faisal2470/RocketDesign/MultiStage/Figures/Multi_Stage_Full.png

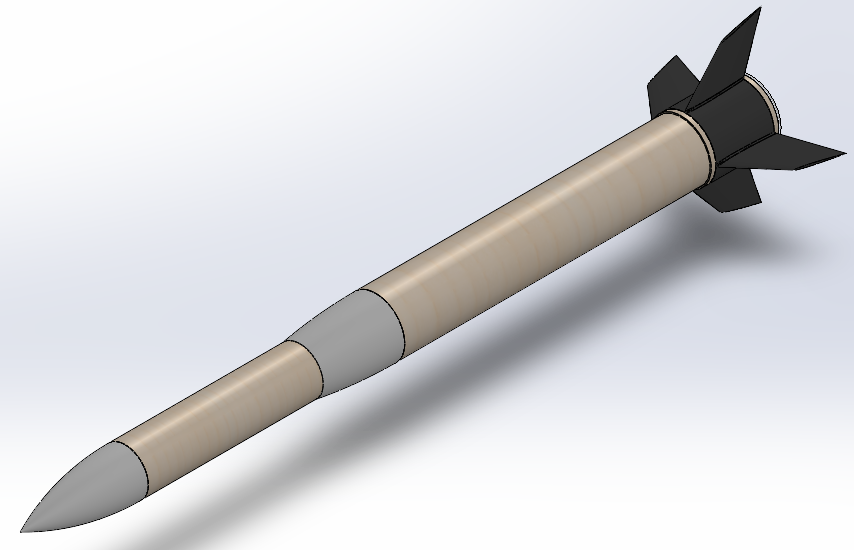
MultiStage/Figures/Multi_Stage_Full.png
