faisal2470/RocketDesign/MultiStage/Figures/Upper_Body_Tube_Multi.png

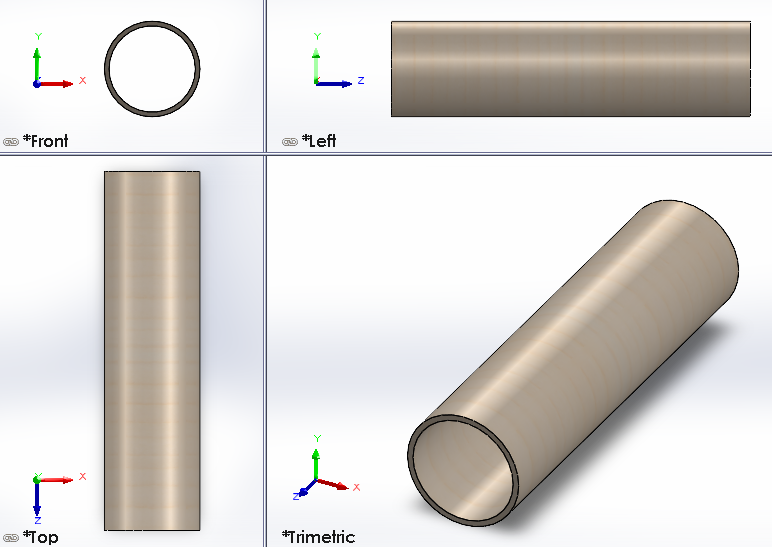
MultiStage/Figures/Upper_Body_Tube_Multi.png
