faisal2470/RocketDesign/Appendix/SemiOgive.pdf

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

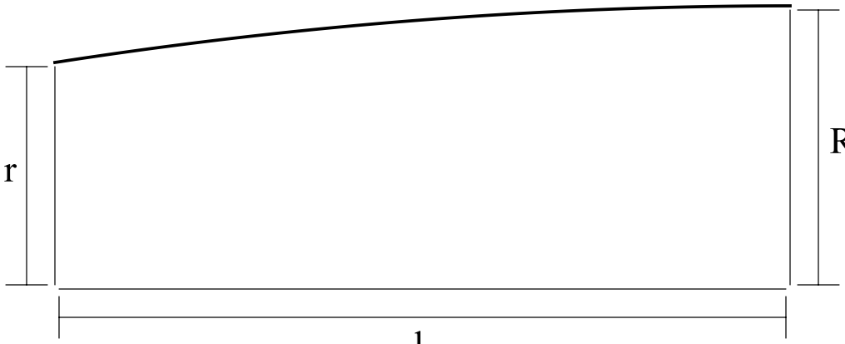
[picture p30: figure]
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
