faisal2470/RocketDesign/MultiStage/Figures/Acc_Vel_Multi.png

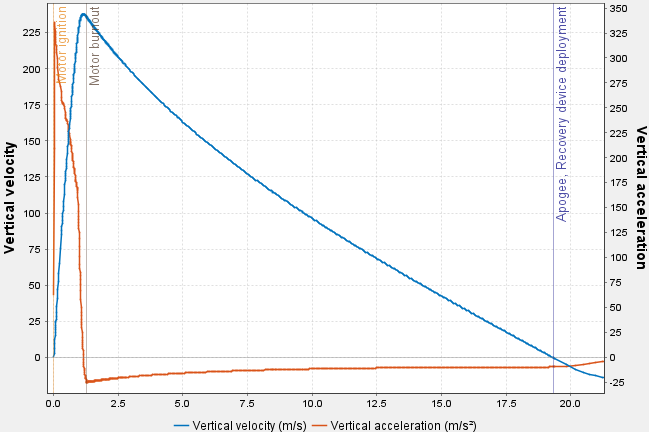
MultiStage/Figures/Acc_Vel_Multi.png
