faisal2470/RocketDesign/MultiStage/Figures/Exploded_View_Multi.png

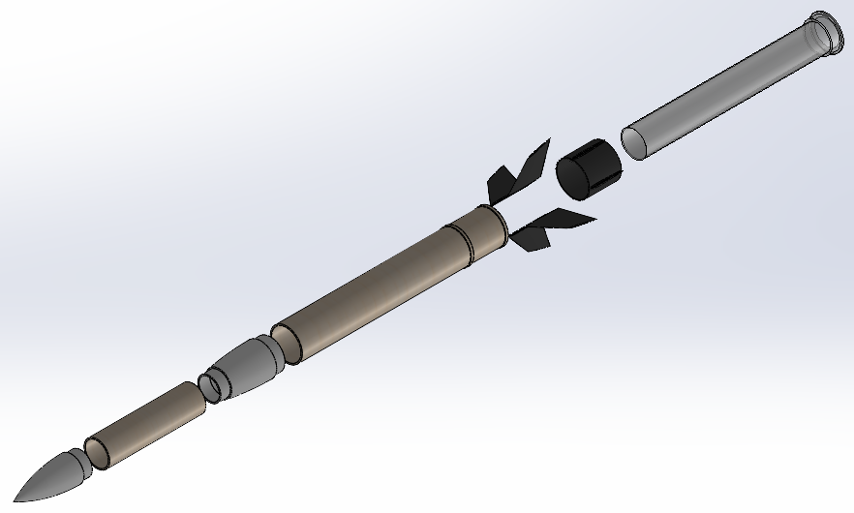
MultiStage/Figures/Exploded_View_Multi.png
