faisal2470/RocketDesign/MultiStage/Figures/Fin_Multi.png

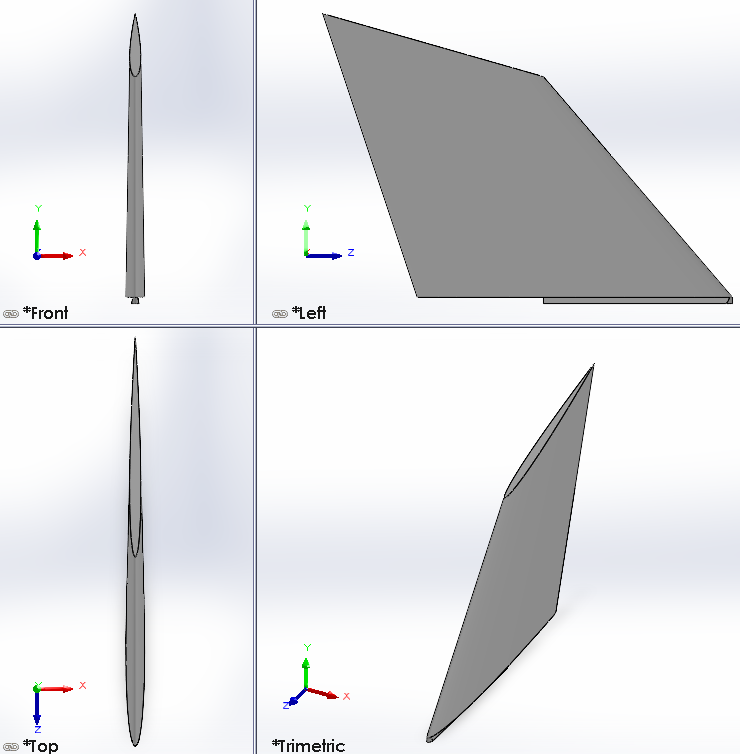
MultiStage/Figures/Fin_Multi.png
