faisal2470/RocketDesign/MultiStage/Figures/Fin_Ring_Multi.png

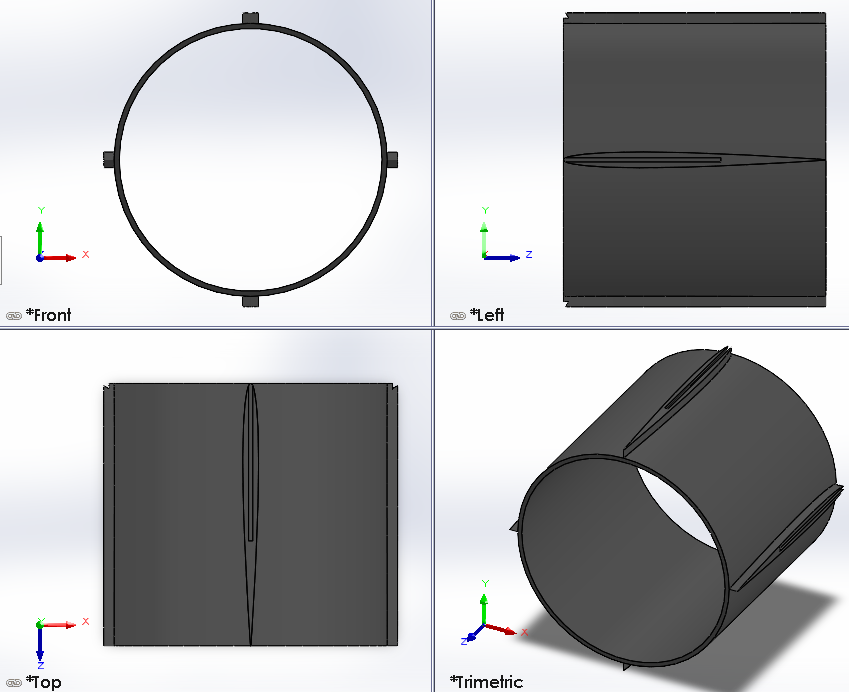
MultiStage/Figures/Fin_Ring_Multi.png
