faisal2470/RocketDesign/MultiStage/Figures/Flight_Path_Multi.png

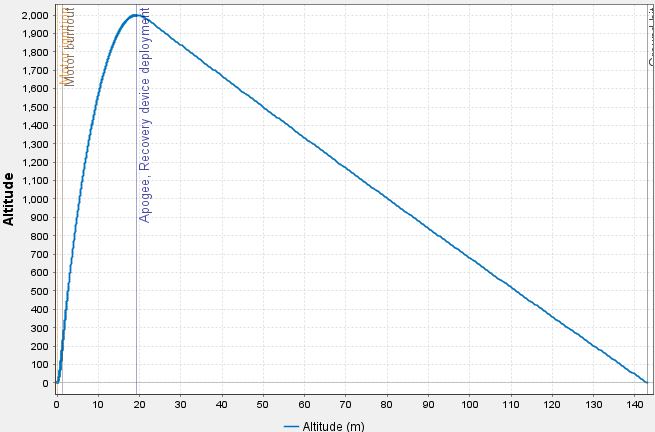
MultiStage/Figures/Flight_Path_Multi.png
