faisal2470/RocketDesign/MultiStage/Figures/Lower_Body_Tube_Multi.png

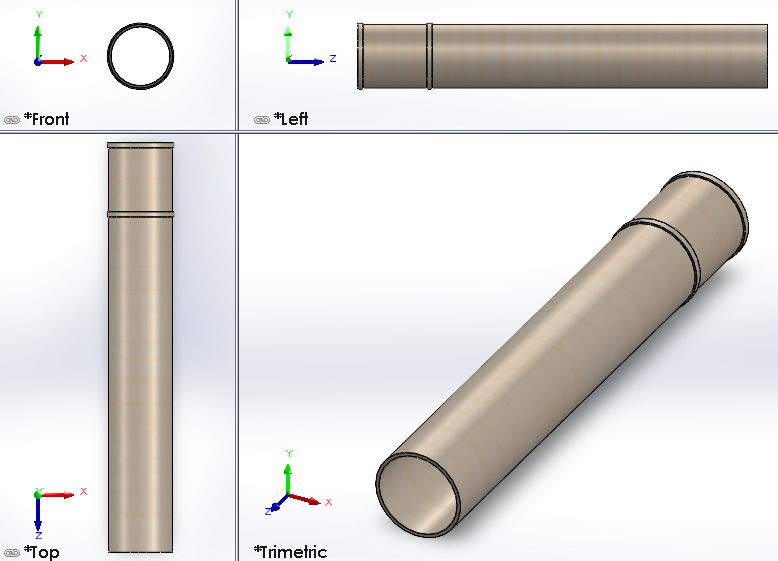
MultiStage/Figures/Lower_Body_Tube_Multi.png
