faisal2470/RocketDesign/MultiStage/Figures/Motor_Mount_Multi.png

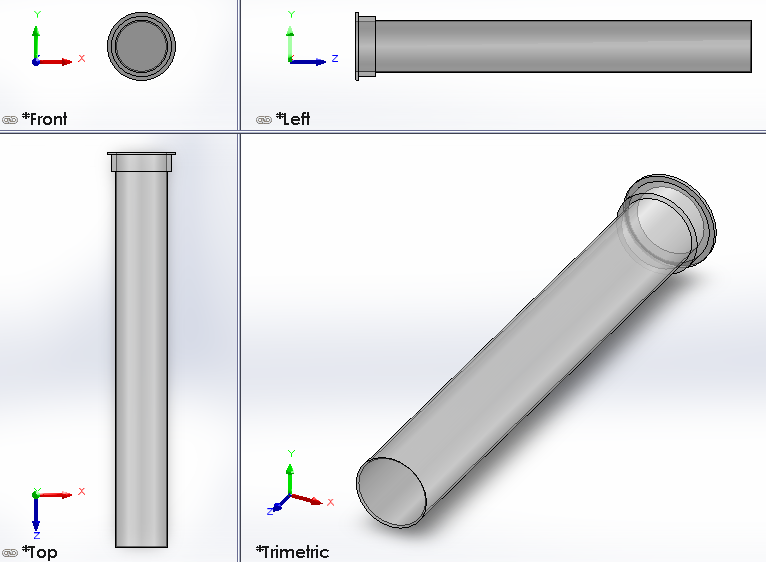
MultiStage/Figures/Motor_Mount_Multi.png
