faisal2470/RocketDesign/MultiStage/Figures/Nose_Cone_Multi.png

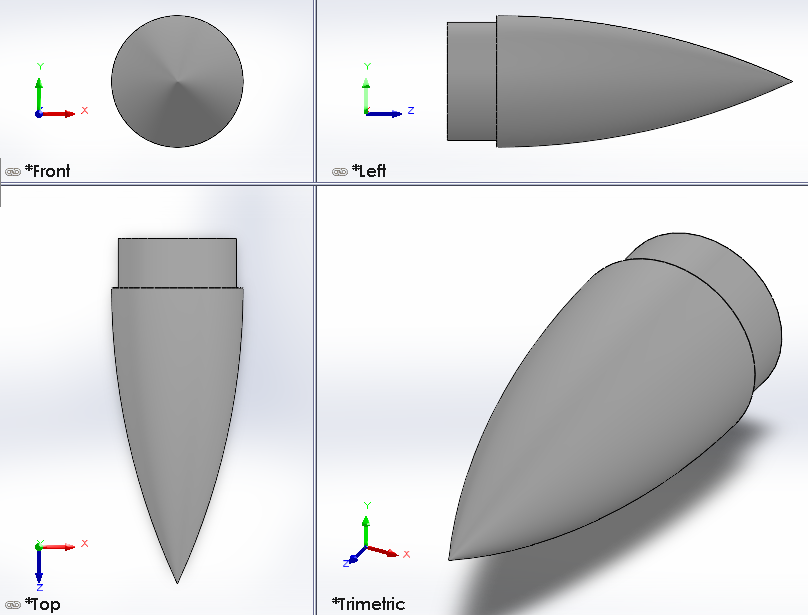
MultiStage/Figures/Nose_Cone_Multi.png
