faisal2470/RocketDesign/MultiStage/Figures/Transition_Multi.png

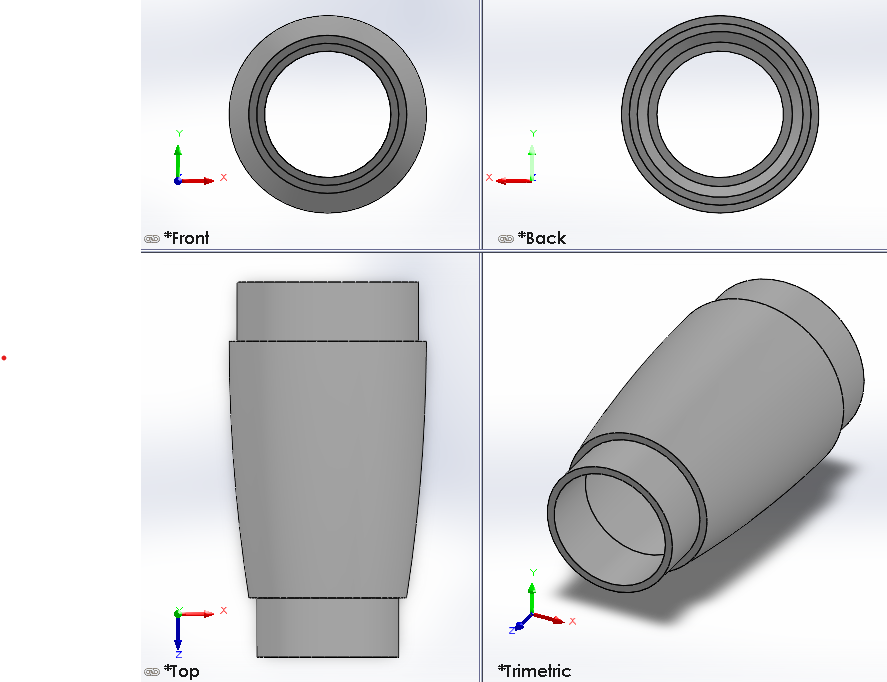
MultiStage/Figures/Transition_Multi.png
