faisal2470/RocketDesign/SingleStage/Figures/Acc_Vel_Single.png

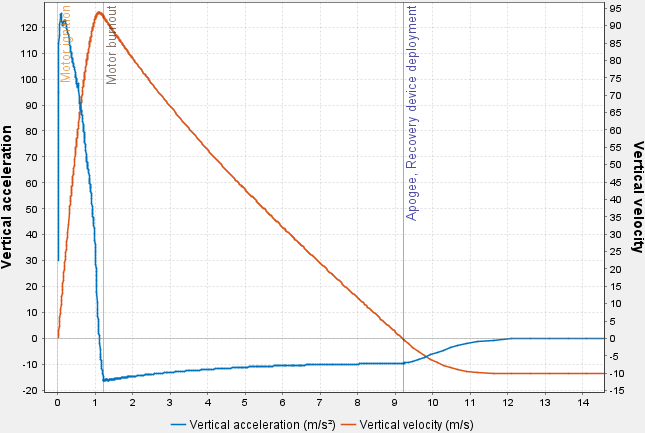
SingleStage/Figures/Acc_Vel_Single.png
