faisal2470/RocketDesign/SingleStage/Figures/Body_Tube.png

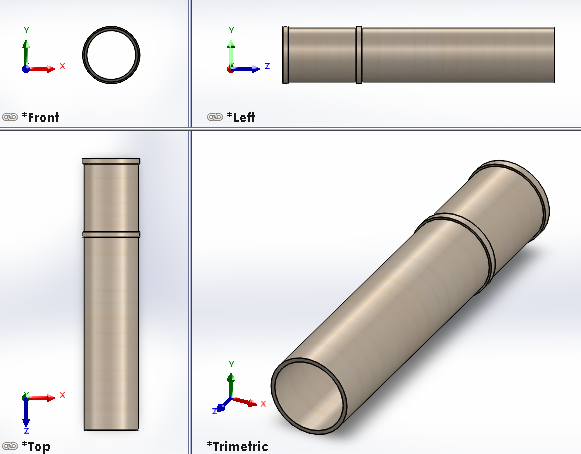
SingleStage/Figures/Body_Tube.png
