faisal2470/RocketDesign/SingleStage/Figures/Exploded_View.png

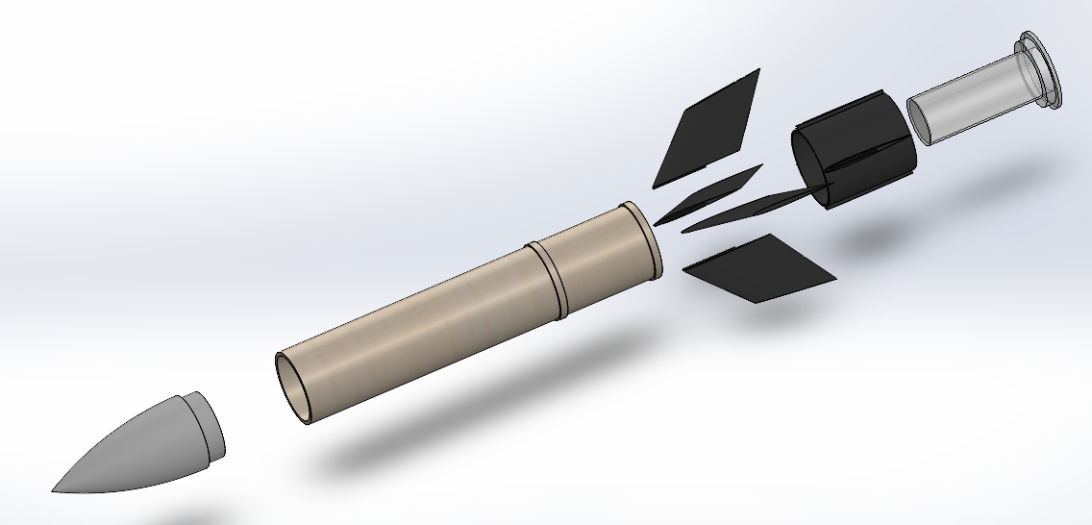
SingleStage/Figures/Exploded_View.png
