faisal2470/RocketDesign/SingleStage/Figures/Fin_Ring.png

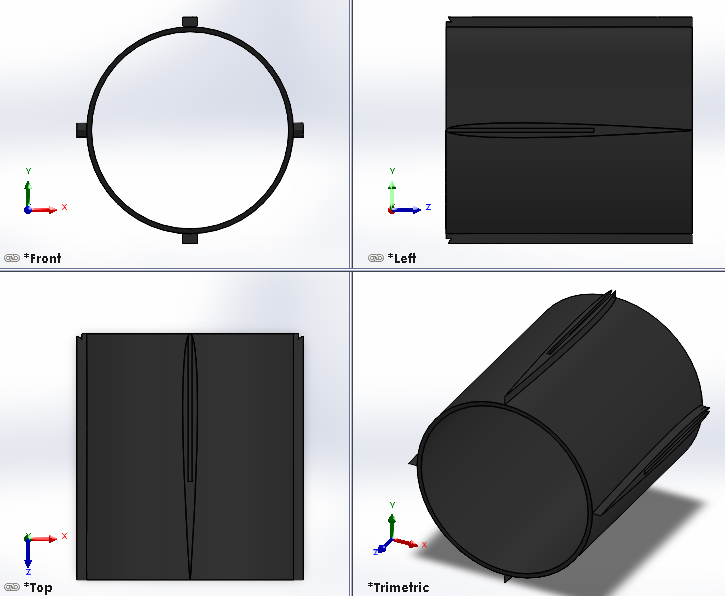
SingleStage/Figures/Fin_Ring.png
