faisal2470/RocketDesign/SingleStage/Figures/Fins_sld.png

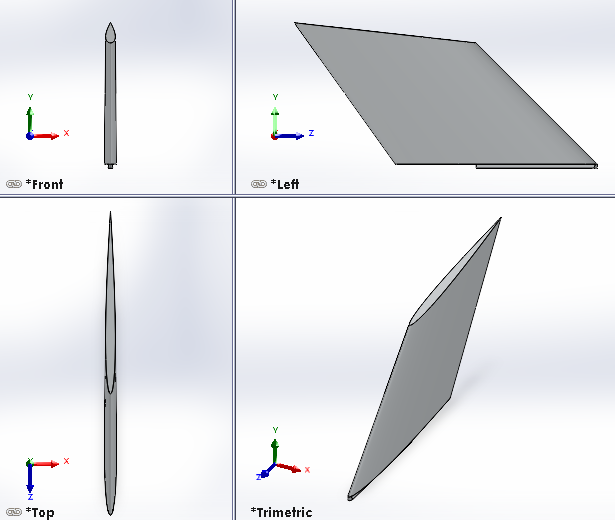
SingleStage/Figures/Fins_sld.png
