faisal2470/RocketDesign/SingleStage/Figures/Flight_Path_Single.png

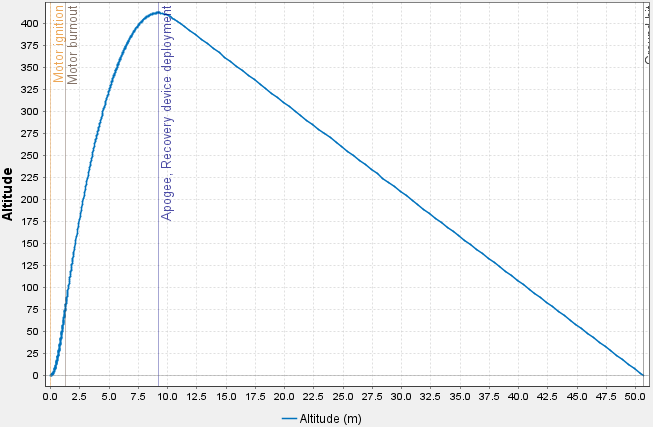
SingleStage/Figures/Flight_Path_Single.png
