faisal2470/RocketDesign/SingleStage/Figures/Motor_Mount.png

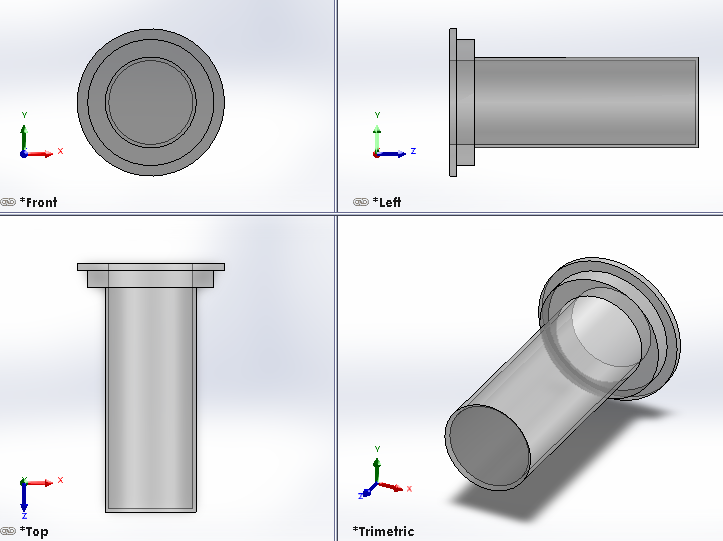
SingleStage/Figures/Motor_Mount.png
