faisal2470/RocketDesign/SingleStage/Figures/Nose_Cone.png

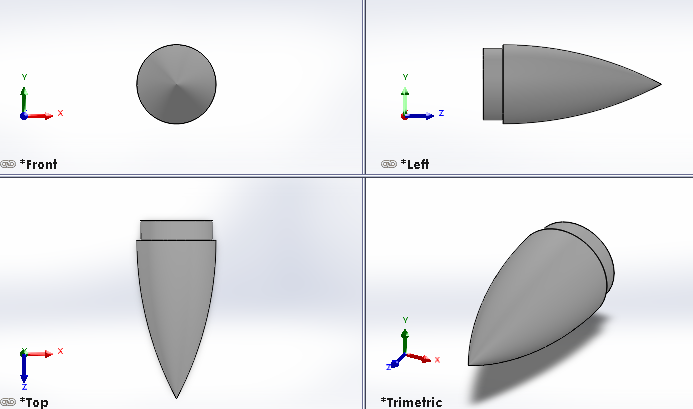
SingleStage/Figures/Nose_Cone.png
