faisal2470/RocketDesign/SingleStage/Figures/Single.png

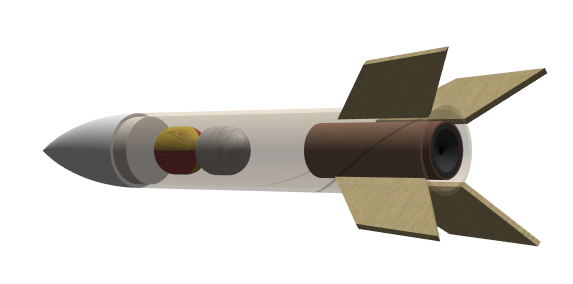
SingleStage/Figures/Single.png
