faisal2470/RocketDesign/MultiStage/SolidPart/Multi Stage Rocket.SLDASM

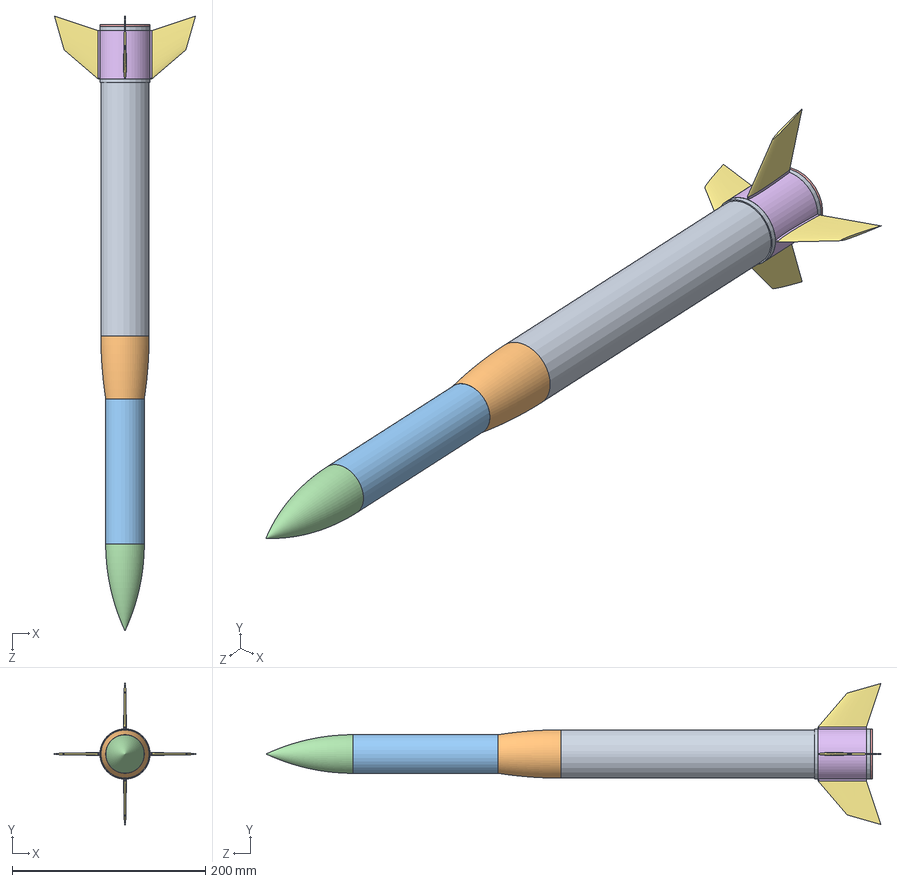
[picture p49: CAD file, 2024-01-03]
MultiStage/SolidPart/Multi Stage Rocket.SLDASM
146.0 x 146.0 x 636.0 mm
Lower Body Tube
Transition
Upper Body Tube
Nose Cone
Motor Mount
Fin Ring
Fins x 4
