faisal2470/RocketDesign/SingleStage/SolidPart/Single_Stage.SLDASM

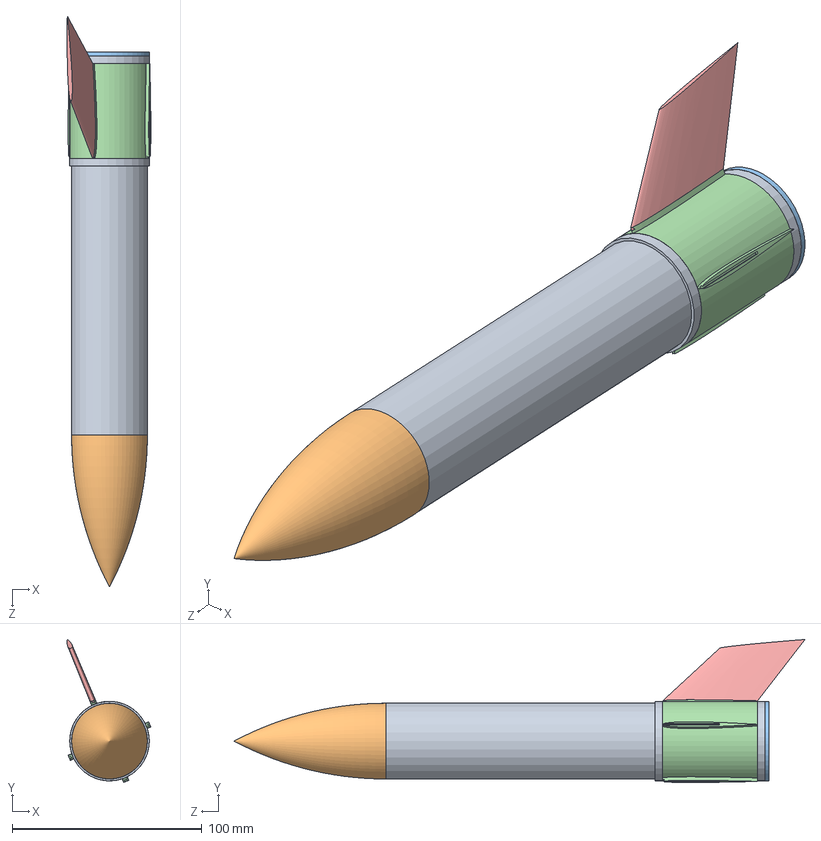
[picture p50: CAD file, 2024-01-03]
SingleStage/SolidPart/Single_Stage.SLDASM
44.2 x 75.4 x 301.0 mm
Body_Tube
Nose_Cone
Motor_Mount
Fin_Ring
Fins
