faisal2470/RocketDesign/MultiStage/SolidPart/Fin Ring.SLDPRT

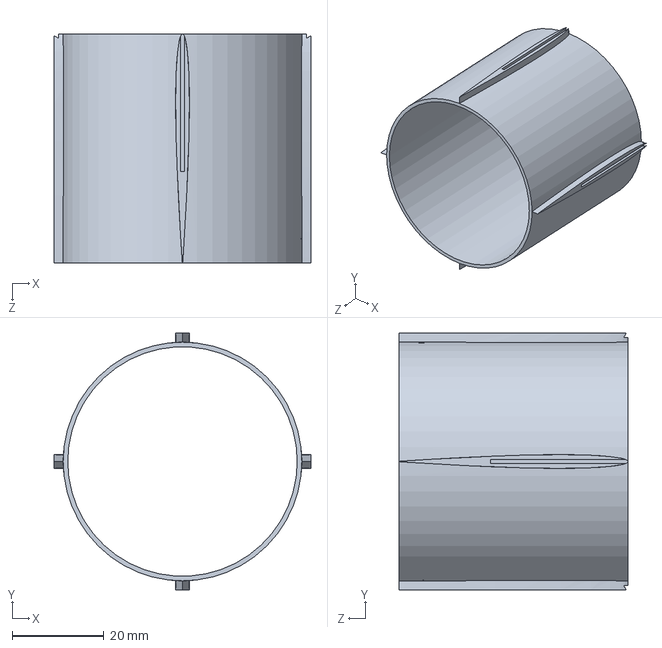
[picture p51: CAD file, 2024-01-03]
MultiStage/SolidPart/Fin Ring.SLDPRT
56.0 x 56.0 x 50.0 mm
