faisal2470/RocketDesign/SingleStage/SolidPart/Fin_Ring.SLDPRT

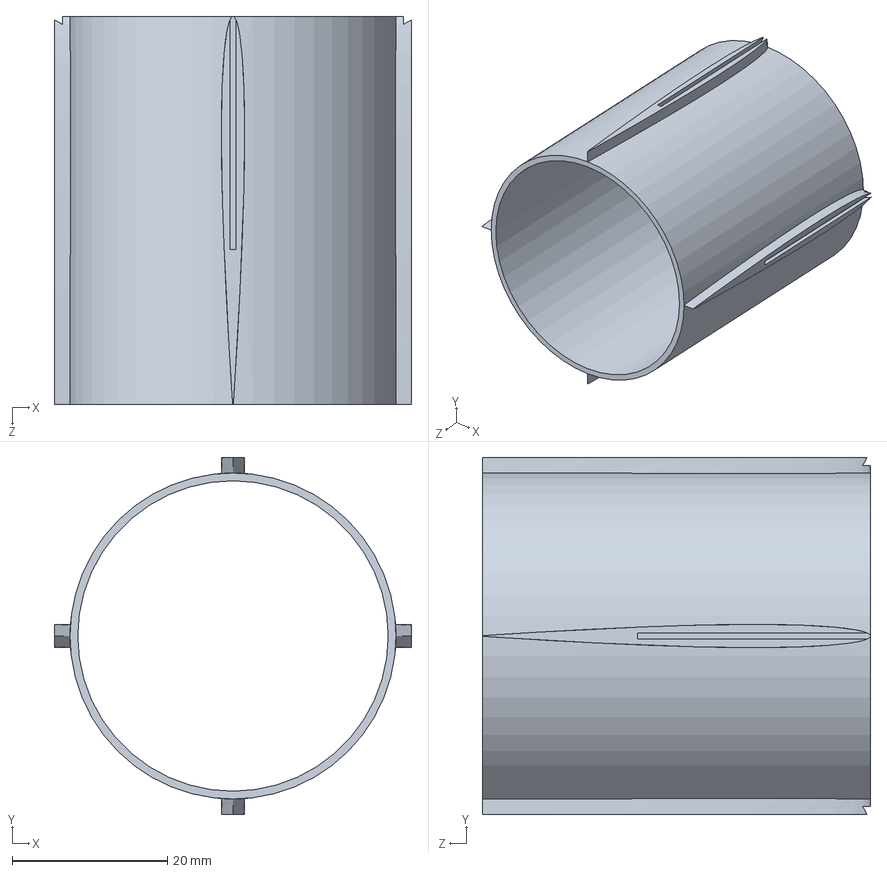
[picture p52: CAD file, 2024-01-03]
SingleStage/SolidPart/Fin_Ring.SLDPRT
46.0 x 46.0 x 50.0 mm
