faisal2470/RocketDesign/MultiStage/SolidPart/Transition.SLDPRT

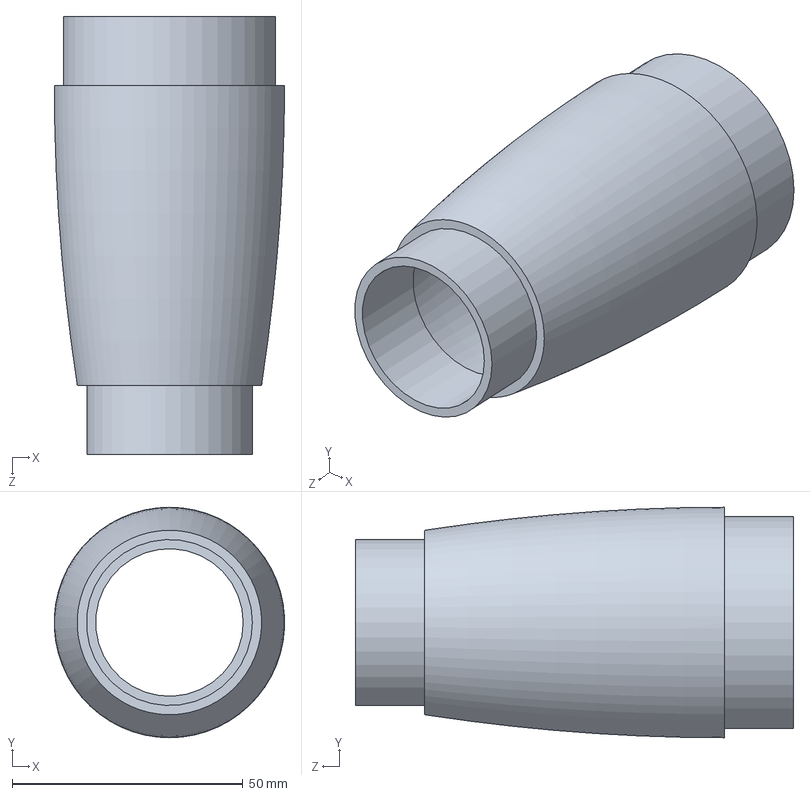
[picture p53: CAD file, 2024-01-03]
MultiStage/SolidPart/Transition.SLDPRT
50.0 x 50.0 x 95.0 mm
