faisal2470/RocketDesign/SingleStage/SolidPart/Motor_Mount.SLDPRT

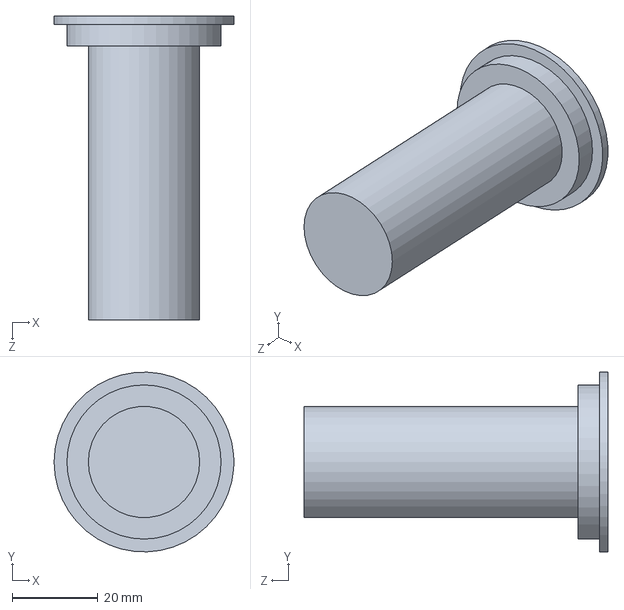
[picture p54: CAD file, 2024-01-03]
SingleStage/SolidPart/Motor_Mount.SLDPRT
42.0 x 42.0 x 71.0 mm
