faisal2470/RocketDesign/MultiStage/SolidPart/Motor Mount.SLDPRT

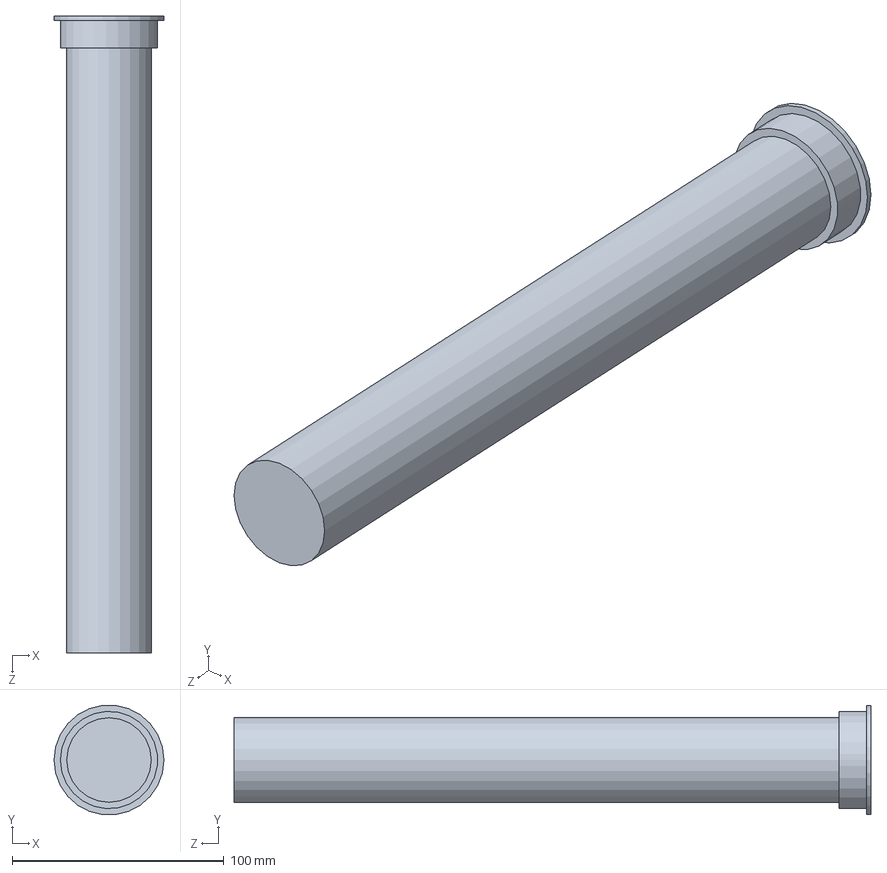
[picture p55: CAD file, 2024-01-03]
MultiStage/SolidPart/Motor Mount.SLDPRT
52.0 x 51.6 x 301.0 mm
