faisal2470/RocketDesign/SingleStage/SolidPart/Body_Tube.SLDPRT

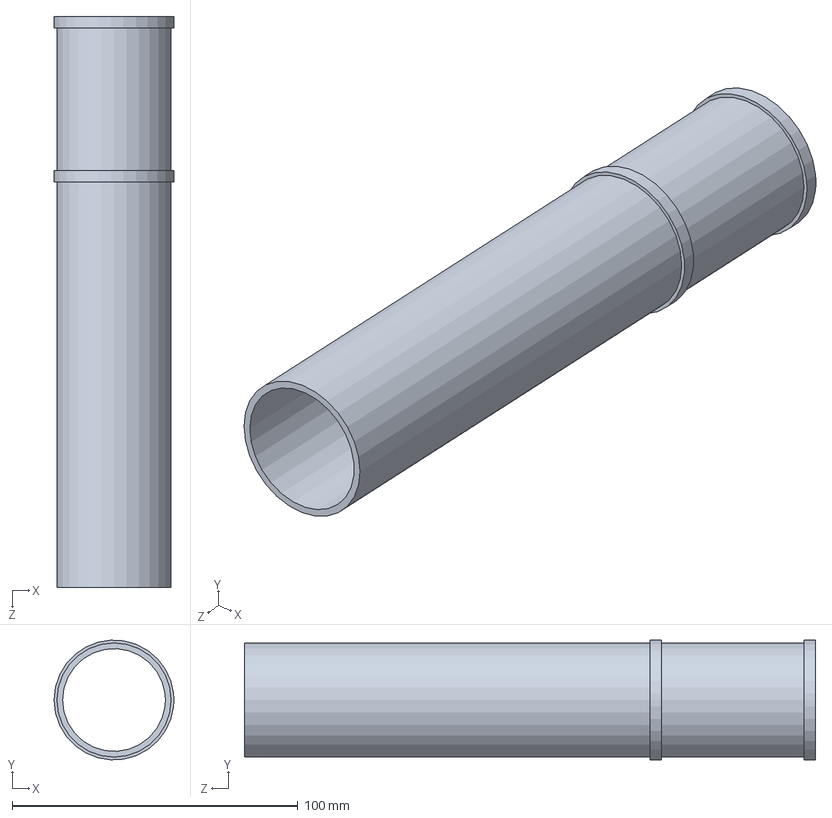
[picture p56: CAD file, 2024-01-03]
SingleStage/SolidPart/Body_Tube.SLDPRT
42.0 x 41.9 x 200.0 mm
