faisal2470/RocketDesign/SingleStage/SolidPart/Fins.SLDPRT

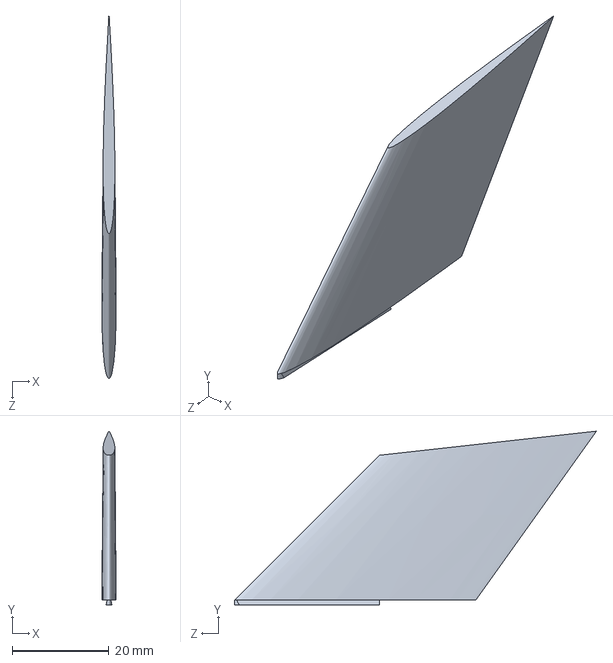
[picture p57: CAD file, 2024-01-03]
SingleStage/SolidPart/Fins.SLDPRT
2.98 x 36.0 x 75.0 mm
