faisal2470/RocketDesign/MultiStage/SolidPart/Upper Body Tube.SLDPRT

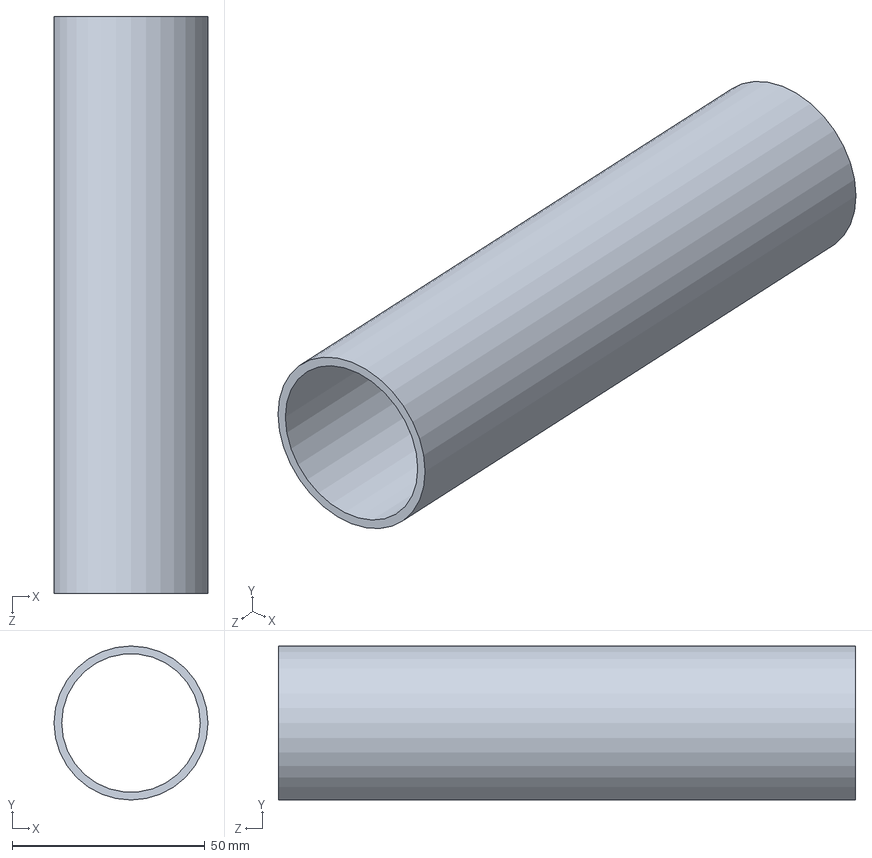
[picture p58: CAD file, 2024-01-03]
MultiStage/SolidPart/Upper Body Tube.SLDPRT
40.0 x 40.0 x 150.0 mm
