faisal2470/RocketDesign/SingleStage/SolidPart/Nose_Cone.SLDPRT

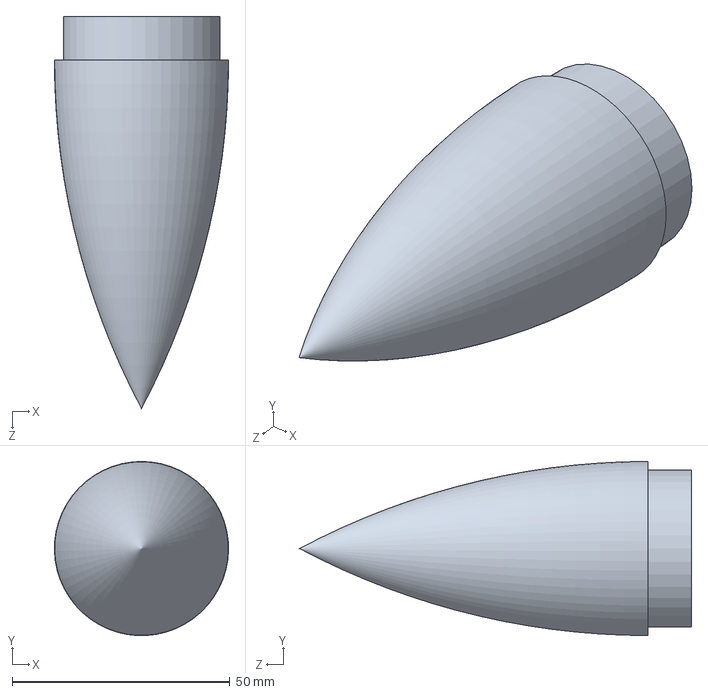
[picture p59: CAD file, 2024-01-03]
SingleStage/SolidPart/Nose_Cone.SLDPRT
40.0 x 40.0 x 90.0 mm
