faisal2470/RocketDesign/MultiStage/SolidPart/Lower Body Tube.SLDPRT

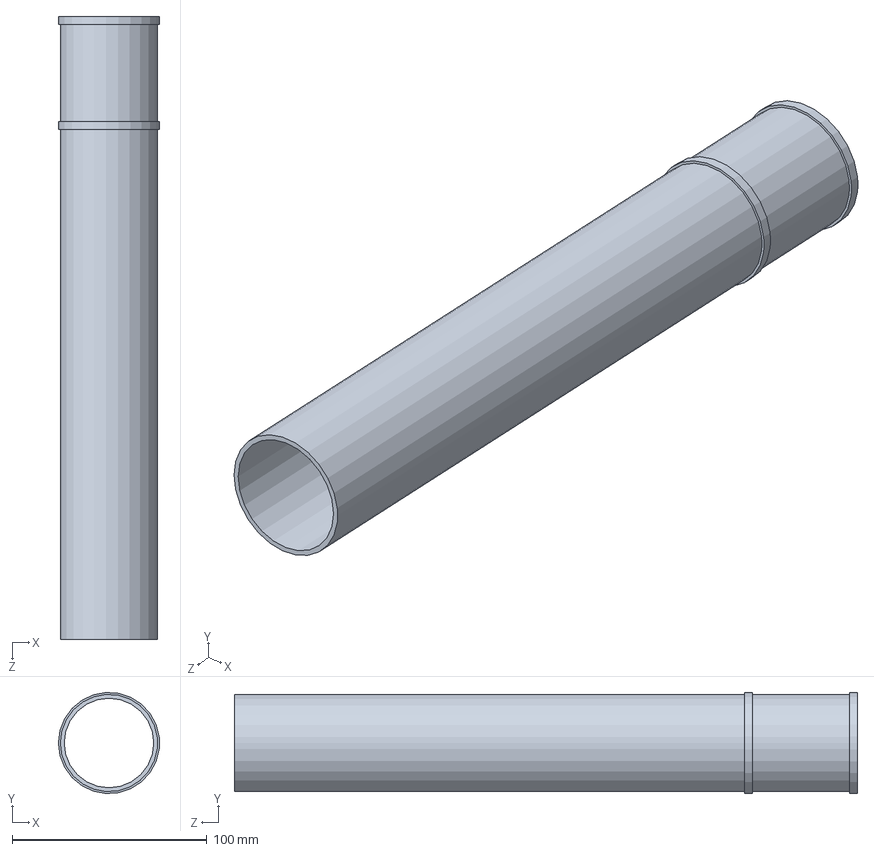
[picture p60: CAD file, 2024-01-03]
MultiStage/SolidPart/Lower Body Tube.SLDPRT
52.0 x 51.9 x 320.0 mm
