faisal2470/RocketDesign/MultiStage/SolidPart/Fins.SLDPRT

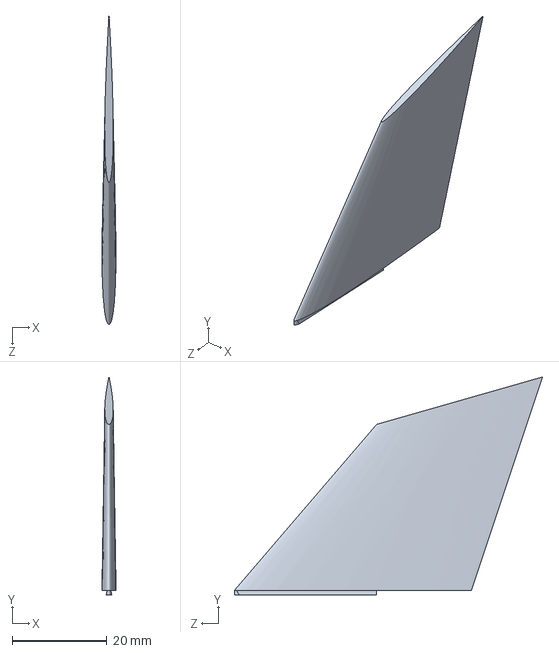
[picture p61: CAD file, 2024-01-03]
MultiStage/SolidPart/Fins.SLDPRT
2.99 x 46.0 x 65.0 mm
