faisal2470/RocketDesign/MultiStage/SolidPart/Nose Cone.SLDPRT

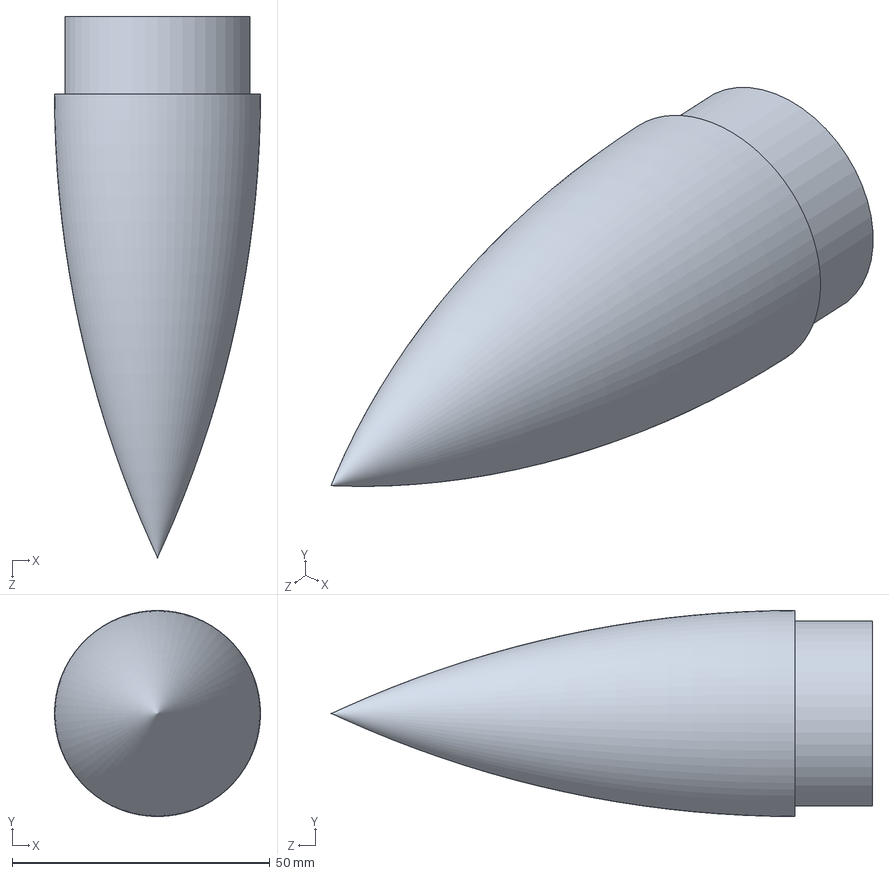
[picture p62: CAD file, 2024-01-03]
MultiStage/SolidPart/Nose Cone.SLDPRT
40.0 x 40.0 x 105.0 mm
