faisal2470/RocketDesign/MultiStage/Figures/Multi_Result.jpg

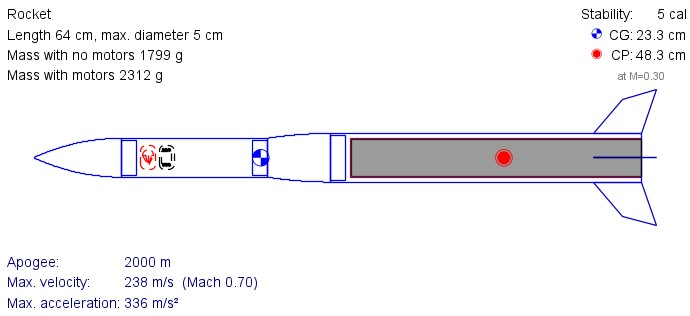
MultiStage/Figures/Multi_Result.jpg
