faisal2470/RocketDesign/SingleStage/Figures/Single_Result.jpg

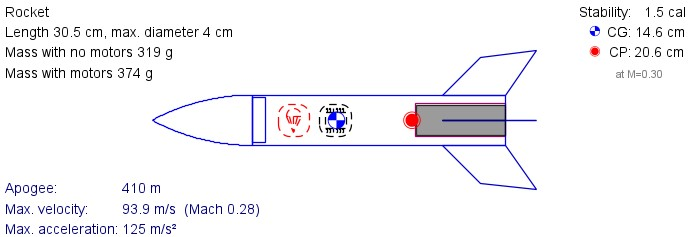
SingleStage/Figures/Single_Result.jpg
